wkcollis1-eng/CO2-Monitor/hardware/adafruit-scd30/adafruit_products_SCD30_sch.png

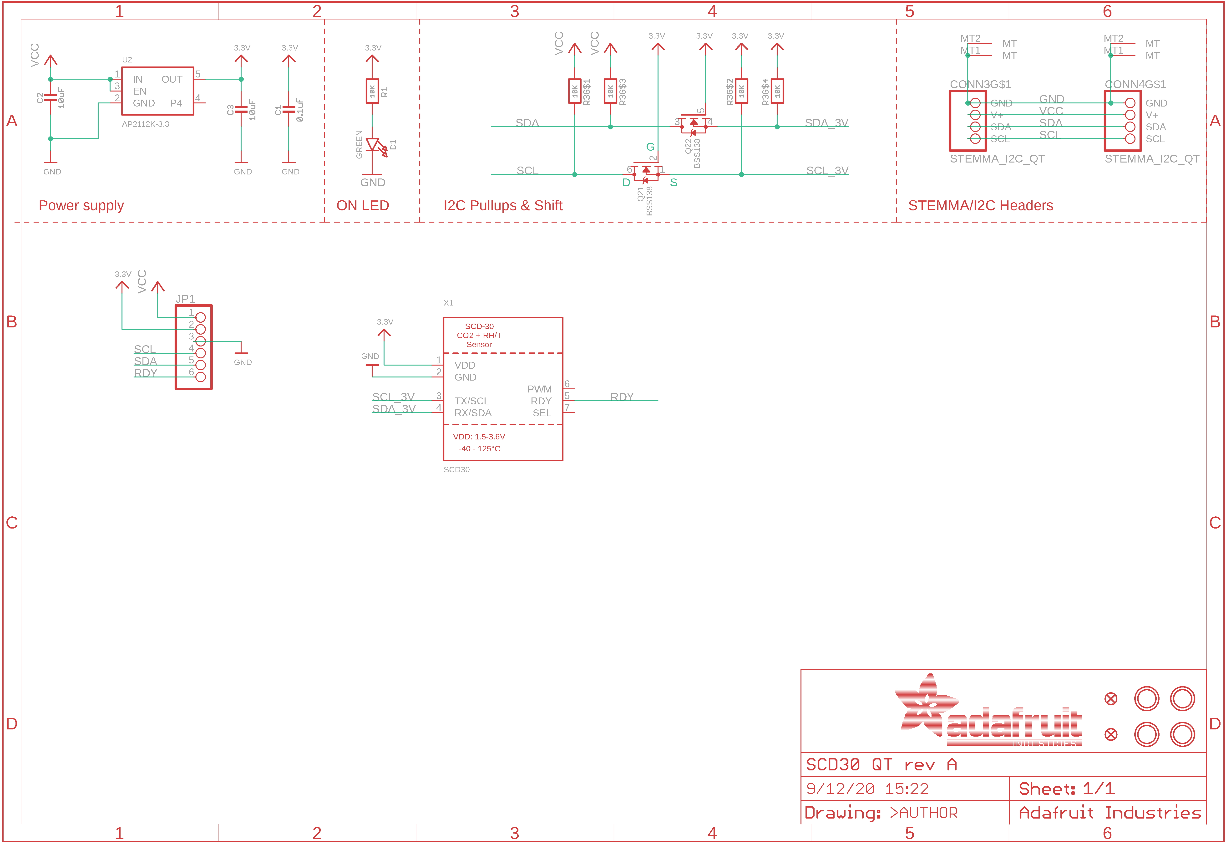
hardware/adafruit-scd30/adafruit_products_SCD30_sch.png
