wkcollis1-eng/CO2-Monitor/hardware/3d/usb-c-type-c-male-connector-cable-1.snapshot.1/USB C Male connector cable.STEP

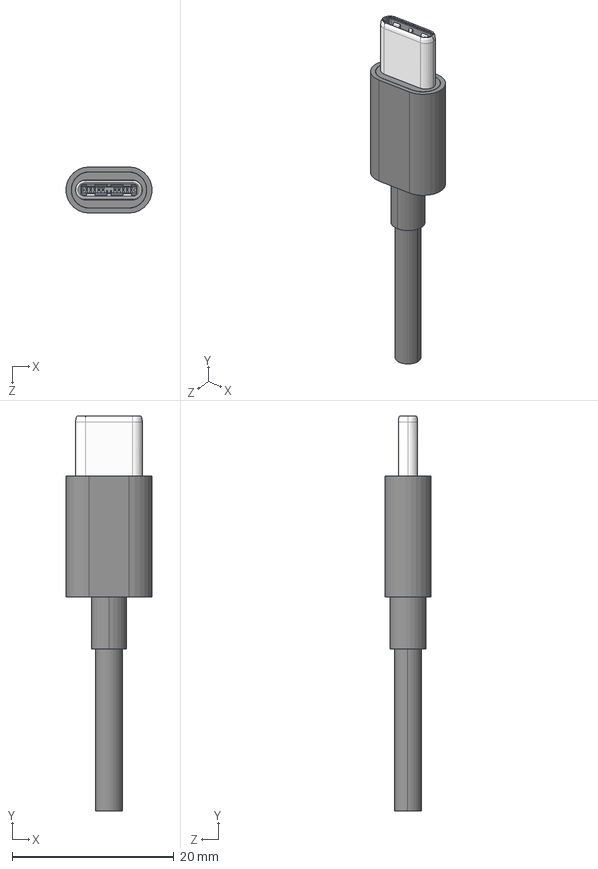
[picture p12: CAD file, 2026-10-18]
hardware/3d/usb-c-type-c-male-connector-cable-1.snapshot.1/USB C Male connector cable.STEP
10.6 x 48.8 x 5.70 mm
USB C Male Cover
USB C Male Connector Board
USB C Male Wire Tube
USB C Male Top Cover
USB C Cable
