wkcollis1-eng/CO2-Monitor/hardware/3d/4867 Adafruit SCD30.step

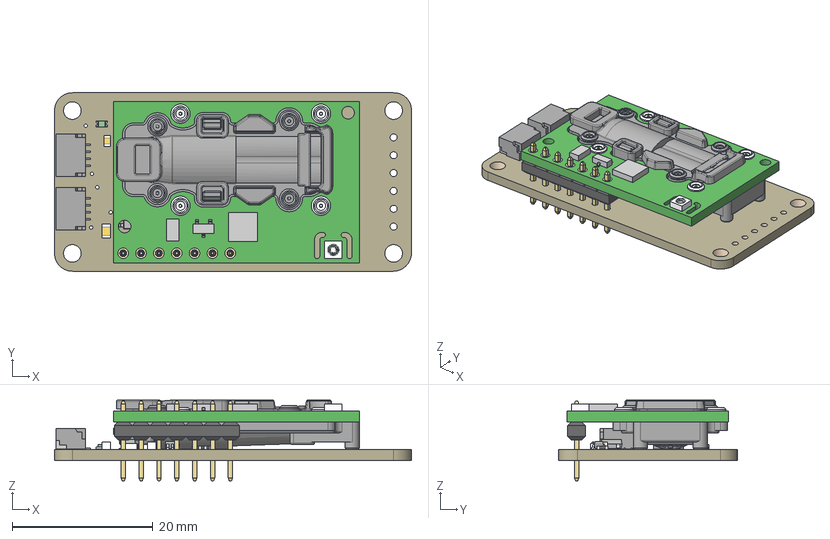
[picture p13: CAD file, 2026-10-18]
hardware/3d/4867 Adafruit SCD30.step
50.8 x 25.4 x 11.5 mm
Board
10uF x 2
AP2112K-3.3
10K x 2
10K_1
BSS138
STEMMA_I2C_QT x 2
GREEN
SCD30
1x7-male-header v1
