wkcollis1-eng/CO2-Monitor/hardware/CO2 Monitor.kicad_pcb

## KiCad design hardware/CO2 Monitor.kicad_pcb (2026-10-18)

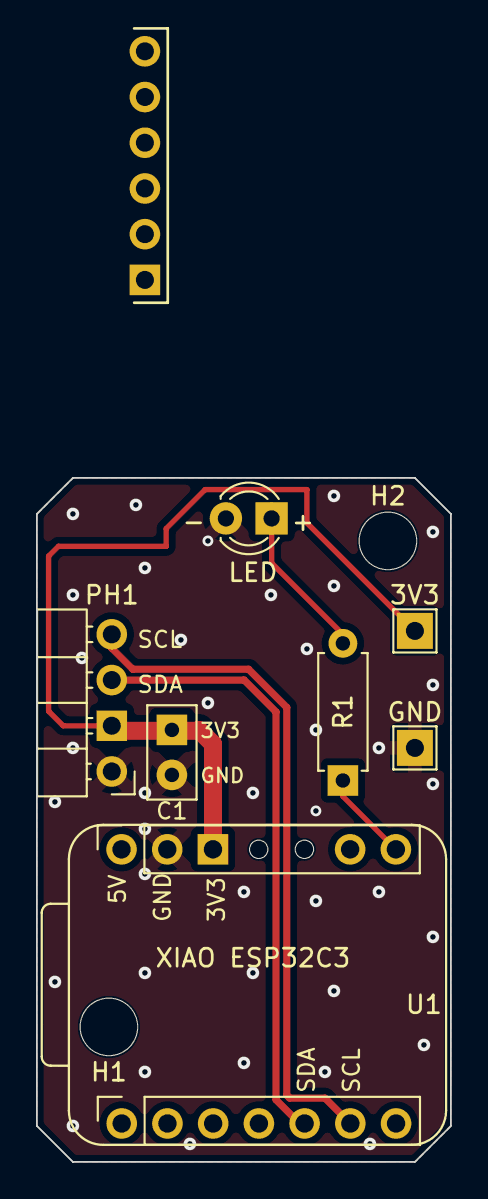
[picture p14: board CO2 Monitor.kicad_pcb from above]

Board: 2 copper layers, 23.0 x 38.0 mm, 9 parts (0 on the bottom side), 6 nets.

Parts:
3V3: TestPoint_THTPad_2.0x2.0mm_Drill1.0mm
C1: .1uF 50V; C_Disc_D5.0mm_W2.5mm_P2.50mm
GND: TestPoint_THTPad_2.0x2.0mm_Drill1.0mm
H1, H2: M3; MountingHole_3.2mm_M3
LED: Green; LED_D3.0mm
PH1: PinHeader_1x04_P2.54mm_Horizontal
R1: 1K Ohm; R_Axial_DIN0207_L6.3mm_D2.5mm_P7.62mm_Horizontal
U1: Xiao ESP32C3; XIAO ESP32C3

Connections:
+3V3: 3V3.1, C1.2, PH1.2, U1.3V3
GND: C1.1, GND.1, LED.1, PH1.1, U1.GND
GPIO20LED: R1.1, U1.GPIO20
LED: LED.2, R1.2
SCL: PH1.4, U1.SCL
SDA: PH1.3, U1.SDA
