wkcollis1-eng/CO2-Monitor/hardware/adafruit-scd30/Adafruit SCD30.brd

## EAGLE design hardware/adafruit-scd30/Adafruit SCD30.brd (2026-10-18)

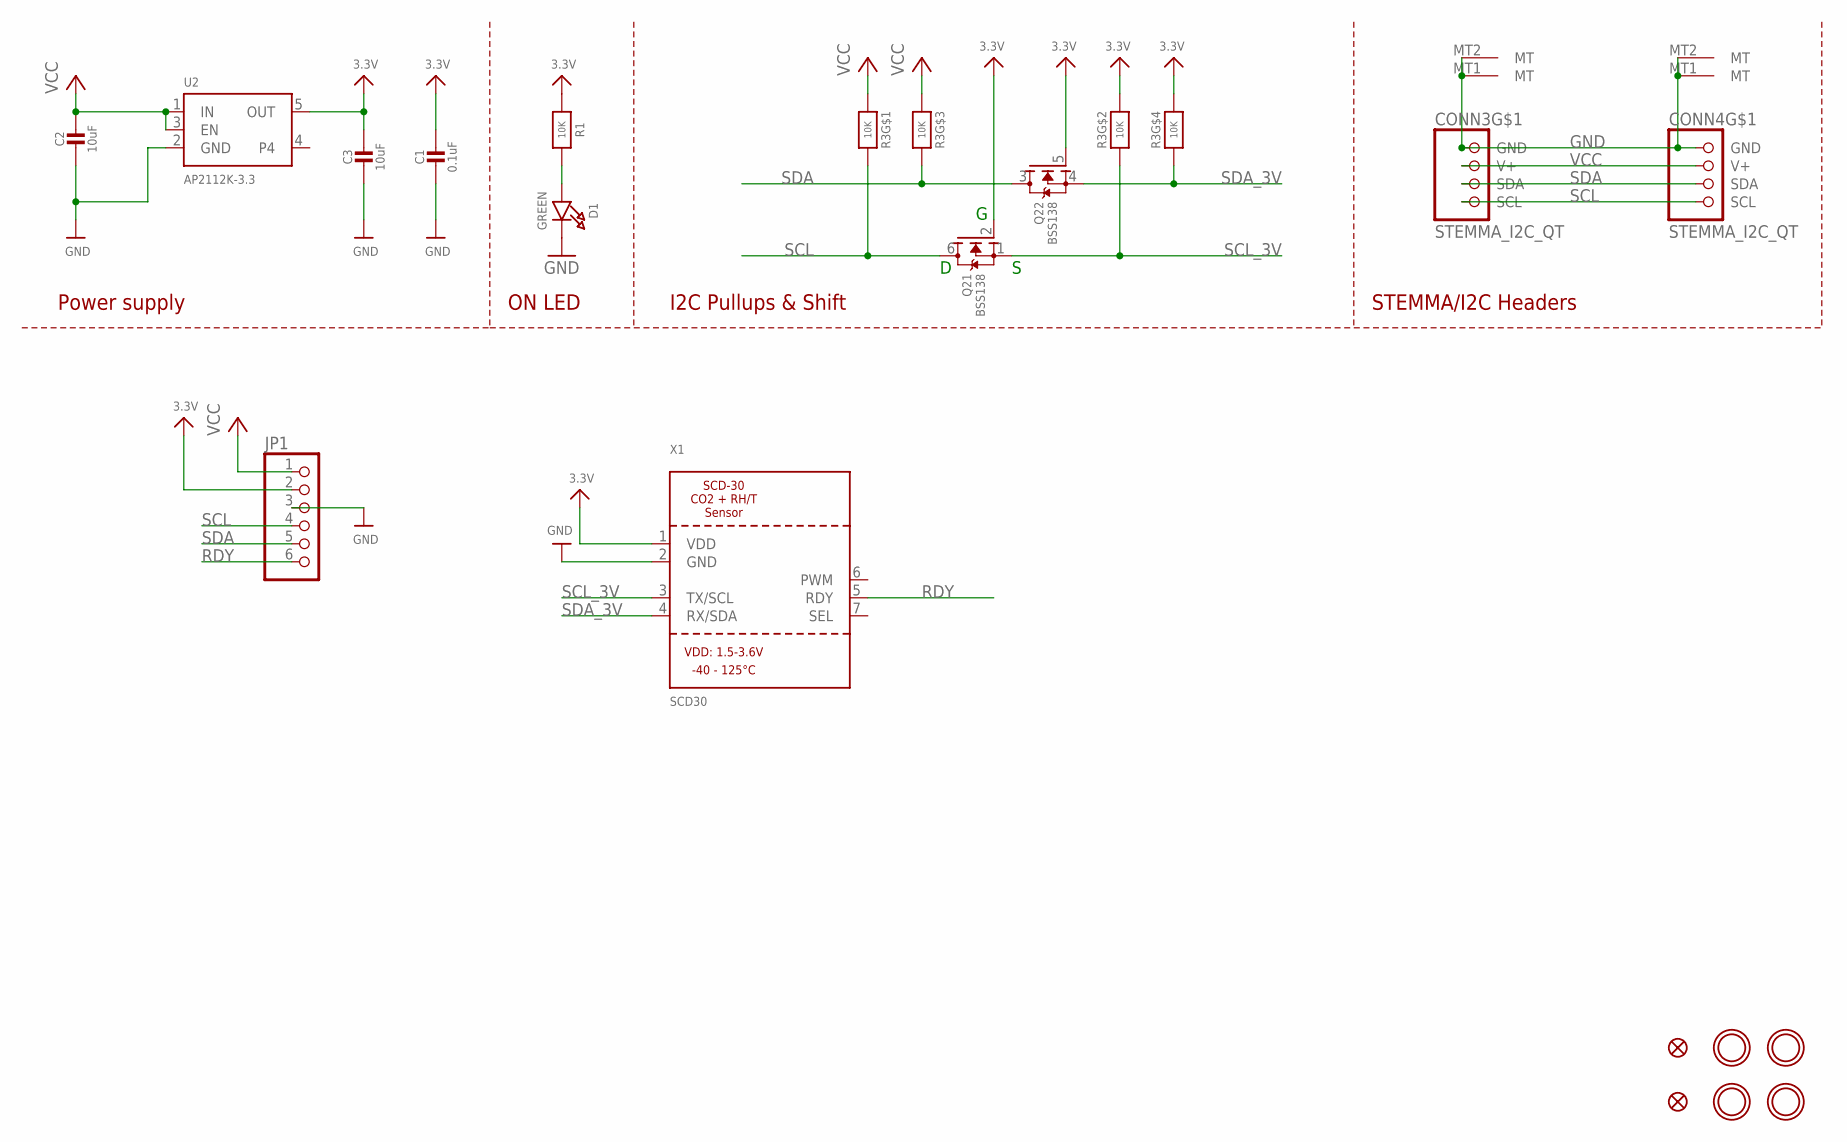
[picture p15: schematic Adafruit SCD30.sch]

Parts:
C1: 0.1uF; 0603-NO
C2, C3: 10uF; 0805-NO
CONN3, CONN4: STEMMA_I2C_QT; JST_SH4
D1: GREEN; CHIPLED_0603_NOOUTLINE
FID3, FID4: FIDUCIAL_1MM
JP1: HEADER-1X670MIL; 1X06_ROUND_70
Q2: BSS138; SOT363
R1: 10K; 0603-NO
R3: 10K; RESPACK_4X0603
U2: AP2112K-3.3; SOT23-5
U$1, U$17, U$19, U$21: MOUNTINGHOLE2.5; MOUNTINGHOLE_2.5_PLATED
X1: SCD30

Connections:
3.3V: C1.1, C3.1, JP1.2, Q2.2 (G), Q2.5 (G), R1.1, R3.2 (1), R3.4 (1), U2.5 (OUT), X1.1 (VDD)
GND: C1.2, C2.2, C3.2, CONN3.1 (GND), CONN3.MT1 (MT), CONN3.MT2 (MT), CONN4.1 (GND), CONN4.MT1 (MT), CONN4.MT2 (MT), D1.C, JP1.3, U2.2 (GND), X1.2 (GND)
unnamed: D1.A, R1.2
RDY: JP1.6, X1.5 (RDY)
SCL: CONN3.4 (SCL), CONN4.4 (SCL), JP1.4, Q2.6 (D), R3.8 (2)
SCL_3V: Q2.1 (S), R3.7 (2), X1.3 (TX/SCL)
SDA: CONN3.3 (SDA), CONN4.3 (SDA), JP1.5, Q2.3 (D), R3.6 (2)
SDA_3V: Q2.4 (S), R3.5 (2), X1.4 (RX/SDA)
VCC: C2.1, CONN3.2 (V+), CONN4.2 (V+), JP1.1, R3.1, R3.3 (1), U2.1 (IN), U2.3 (EN)

Notes on the sheet:
I2C Pullups & Shift
STEMMA/I2C Headers
ON LED
Power supply

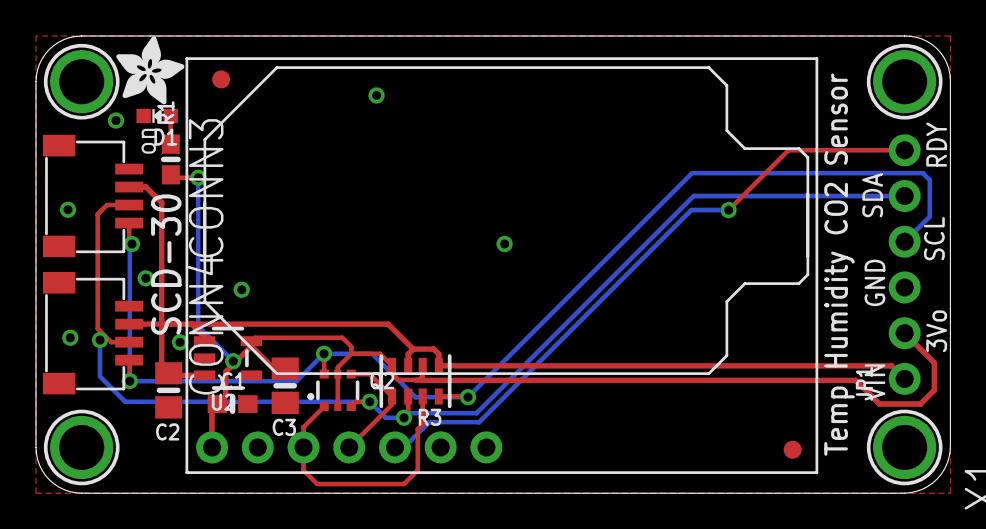
[picture p16: board Adafruit SCD30.brd from above]

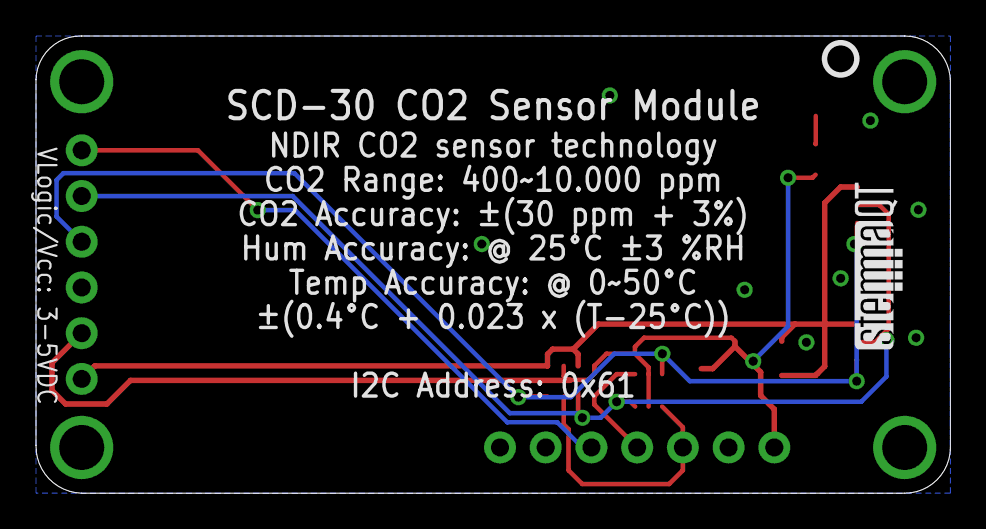
[picture p17: board Adafruit SCD30.brd from below]

Board: 2 copper layers, 50.8 x 25.4 mm, 21 parts (2 on the bottom side), 9 nets.

Other parts of the board:
U$22: ADAFRUIT_3.5MM
U$25: PCBFEAT-REV-040
U$30: STEMMAQT
