wkcollis1-eng/CO2-Monitor/(commit log)

2026-10-18 Repository scaffolding: .gitignore, gitleaks rules, pre-commit config
    .gitleaks.toml and .pre-commit-config.yaml come from the Tools repo. Two
    repo-local changes to the latter, both explained in the file:
    check-added-large-files raised to 5 MB for the vendor STEP models and
    datasheets, and hardware/ + docs/ excluded from the two whitespace fixers
    so KiCad and vendor files stay as their tools and publishers wrote them.
    .gitignore keeps secrets.yaml out first of all, then the ESPHome and
    watchdog-harness build output and KiCad's per-user state.
2026-10-18 Import the CO2 node firmware, harness, KiCad board and vendor sources
    Moved from C:\sandbox\co2_nodes (the ESPHome draft and its watchdog sim)
    and OneDrive\Desktop\CO2 Monitor (the KiCad enclosure fit-check board, the
    SCD30 and Hammond 1551V4 sources). Every file is byte-identical to its
    source (cmp, 2026-10-18); only the location changed:
    co2_nodes/*.yaml -> esphome/
    co2_nodes/harness/ -> harness/ (gen.py, faults.py follow, ruff)
    CO2 Monitor/KiCad/ -> hardware/ (relative layout inside unchanged)
    vendor STEP models -> hardware/3d/
    Adafruit SCD30 EAGLE -> hardware/adafruit-scd30/
    datasheets, drawings -> docs/
    hardware/3d/seeed-studio-xiao-esp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
    [4867 Adafruit SCD30.step, Adafruit SCD30.brd, Adafruit SCD30.sch, CO2 Monitor.kicad_pcb, Seeed_XIAO_ESP32C3.kicad_sch, USB C Male connector cable.STEP, seeed-studio-xiao-esp32-c3.step]
2026-10-18 harness: import gen.py and faults.py, ruff-formatted, E741 fixed
    The watchdog sim's two scripts, from C:\sandbox\co2_nodes\harness. They
    are the only files of the import that are not byte-identical to their
    source, and are committed apart from it for that reason:
    - ruff (pinned v0.15.9) blocked on E741, `l` as a loop variable, three
    times in faults.py: renamed to `line`.
    - ruff-format reflowed both files (double quotes, wrapped calls).
    - gen.py's trailing "# the stub below models exactly this filter" moved
    onto its own line above its assert, so the formatter does not wrap
    the assert around it. Comment kept, word for word.
    Behaviour-identical, shown two ways on 2026-10-18: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
2026-10-18 hardware: 3D model paths relative to ${KIPRJMOD}, so a clone resolves them
    Five (model "...") paths in CO2 Monitor.kicad_pcb were absolute paths into
    C:/Users/wkcol/OneDrive/Desktop/, so they resolved on one machine only, and
    only until those folders moved. Each is rewritten as a single span, matched
    exactly once:
    SCD30 STEP -> ${KIPRJMOD}/3d/4867 Adafruit SCD30.step
    Hammond 1551V4 base -> ${KIPRJMOD}/CO2_Monitor/CO2_Monitor.3dshapes/Hammond_1551V4_Base.step
    Hammond 1551V4 cover -> ${KIPRJMOD}/CO2_Monitor/CO2_Monitor.3dshapes/Hammond_1551V4_Cover.step
    USB-C cable STEP -> ${KIPRJMOD}/3d/usb-c-type-c-male-connector-cable-1.snapshot.1/USB C Male connector cable.STEP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
    [CO2 Monitor.kicad_pcb]
2026-10-18 pre-commit: correct the largest-file figure in the --maxkb comment
    The comment gave 4,254,159 bytes for the USB-C cable STEP. That is the
    size of the GrabCAD snapshot .zip the STEP arrived in, which is not in
    this repo. The STEP itself is 4,253,334 bytes, still the largest tracked
    file. The error is recorded beside the corrected figure. The 5120 KB limit
    does not change.
2026-10-18 Licences and third-party notices
    Three-way model, as mmwave-presence-node: CERN-OHL-S v2 for hardware/,
    MIT for esphome/ and harness/, CC BY 4.0 for the README. LICENSE-CODE and
    LICENSE-HARDWARE are mmwave's files unchanged (same blobs).
    THIRD_PARTY_NOTICES.md records, for each vendor file, its source and the
    terms that apply, and says where that could not be verified:
    - the SCD30 STEP (Adafruit_CAD_Parts, MIT): the notice is reproduced
    - the SCD30 EAGLE board/schematic (Adafruit-SCD-30-PCB, CC BY-SA 3.0)
    - the Hammond 1551V4 meshes, split into base and cover (a modification)
    - the USB-C cable mesh: author and licence NOT recovered (GrabCAD 403)
    - the footprints and schematic redraw derived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
2026-10-18 README: what the node is for, status, hardware, firmware, harness, board caveats
    Written for readers who may build the node. It covers the three unattended
    moments the firmware is built around, a status table that claims no more
    than is on record (draft firmware, compiled on ESPHome 2026.9.1, watchdog
    host-simulated, not deployed, no new PCB), the PH1 pinout and the 3V3-only
    rule, the enclosure fit figures with their provenance tags, the entities,
    the outdoor-FRC procedure, how to run the harness and what it does not
    prove, and the known board caveats:
    - design rules inherited from another board
    - a DRC count that varies run to run on an unchanged file
    - 7 unresolved model refs
    - broken libr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
2026-10-18 README: two 3D renders of the fit-check model
    Bill's KiCad 3D-viewer renders (cover off; cover lifted), placed in
    hardware/ and embedded after the intro, as in mmwave-presence-node.
    The caption says they are renders, not photographs, that the standoff
    height is not final, and that the model does not show the USB cable's
    exit from the enclosure.
    Both renders show the USB-C plug mesh whose provenance was not
    recovered, so THIRD_PARTY_NOTICES.md no longer says "nothing else uses
    it", and the README's third-party row says so too.
    Checked: git diff -U0 shows 3 README hunks + 1 notices hunk only;
    local links/anchors bad: 0 (injected bad anchor + bad image path -> 2);
    check_provenance --all: 0 WA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
2026-10-27 firmware 1.1: fault-only LED and an LED Test button
    The LED strobes at 5 Hz while CO2 Sensor Fault is on, including after a
    recovery reboot, and is dark the rest of the time. LED Test strobes it for
    15 s, to prove the LED and that it can be seen.
    harness/led.py tests the LED lambda both ways, the way faults.py tests the
    watchdog. The ruff-format hook reformatted it on the way in; the AST is
    identical to the file that was run.
    Gate at this commit: "FAULTS: PASS (0 of 6 directions wrong)",
    "LED: PASS (0 of 5 directions wrong)". Flashed to the bedroom node
    2026-10-27.
2026-10-27 firmware 1.2: a 2 s measurement window before forced recalibration
    Sensirion requires a 2 s measurement rate for at least two minutes before
    FRC [S: SCD30 Interface Description v1.0-D1, p14]; the node normally
    measures every 60 s. frc_prepare opens the window, and the Calibration
    entity reads "2 s window: wait", then "ready", then "applied N ppm" or the
    reason it was refused. forced_recalibration is refused before ready, or
    outside 400 to 2000 ppm.
    The window ends with a reboot 20 min after frc_prepare. Setup writes the
    60 s rate back, because the SCD30 keeps its interval in non-volatile memory
    (p9), so a forgotten window cannot leave it at 2 s.
    Gate at this commit: "FAULTS: PASS (0 of 6 d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
2026-10-27 firmware 1.3: SCD30 temperature and humidity as diagnostics
    Bill: "can we see the units temp/humidity its recording?" Two diagnostic
    sub-sensors, named "(self-heated)": the SCD30 heats itself [S: SCD30
    Interface Description v1.0-D1, p15], so they are not room readings. They
    are the only view of the thermal equilibrium that calibration assumes
    [S: SCD30 Design-In Guidelines D1, p2]. No temperature_offset.
    The stale watchdog blanks both with CO2: one read carries all three, and a
    failed read publishes none (scd30.cpp:186-192).
    Harness: a timed check that both go unknown with CO2, a check that a
    healthy sensor never blanks them, and faults F6-F8. The first draft checked
    the end state and coul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
2026-10-27 README: the FRC acceptance rule, and the 2026-10-27 porch calibration
    The rule used: each minute's sd <= 5 ppm, the 3 minute means within 5 ppm
    of each other, and the 3-min mean no higher than 469 ppm [D: 426 + 43].
    There is no lower bound on purpose: a plume can only raise outdoor CO2.
    The first rule had one, and it rejected a flat window that read about
    82 ppm low (R13).
    Records the calibration: 3-min mean 340.9 ppm, then 425.7 after FRC at
    426 [M]; "PERSIST: PASS (after - before = -2.0 ppm, limit 43)" through
    the window-end reboot. Says to judge nothing from the first 5 min after
    a boot, because 2 of 3 boots that day started low and climbed.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
2026-10-27 README: R13 - the low start was the measurement rate, not the boot
    The calibration record said the first readings after 2 of 3 boots
    started low and climbed. They did not follow the boots. Each climb began
    when frc_prepare moved the SCD30 from 60 s to 2 s, and each return to
    60 s brought the reading down again: in the same porch air the 60 s
    reading sat 60 to 70 ppm below the 2 s reading [D, n = 3 transitions,
    one unit, one afternoon]. The mechanism is unknown.
    FRC is taken at 2 s, as the Interface Description asks (p14), and the
    node runs at 60 s, so its readings likely sit about 65 ppm low [I,
    falsified by the node at 60 s outdoors, settled, reading near 426]. The
    PERSIST figure compared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
2026-10-27 firmware 1.4: measure every 2 s; CO2 is the 1-minute mean, CO2 (2 s) every reading
    The SCD30 read 60-70 ppm lower at 60 s than at 2 s in the same air, and
    FRC is taken at 2 s (Interface Description p14). 1.4 runs at 2 s always.
    - scd30 update_interval 2s; its CO2 becomes co2_2s, "CO2 (2 s)".
    - "CO2" is a copy of it through throttle_average 60s, so the entity id
    and its history carry on. SCD30 temperature and humidity: 60 s means.
    - frc_prepare, frc_window and g_frc_open_ms removed. FRC is allowed from
    2 min after boot (g_frc_ready, set by on_boot).
    - Calibration: "2 s rate; FRC wait (2 min after boot)" / "2 s rate; FRC
    ready", plus the last result; published only on a change.
    - The wa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
2026-10-27 README: firmware 1.4 - always 2 s, the 1-minute mean, the OTA step
    - Status, Entities and Settings for 1.4: CO2 is the 1-minute mean, CO2
    (2 s) is new (up to 43,200 recorder states a day [D: 86,400 / 2]).
    - Calibration: frc_prepare is gone; FRC is allowed from 2 min after boot.
    - The OTA step, 60 s -> 2 s: about +86 ppm in the 2 s readings and +78
    to +85 in the settled 1-minute means, against a +60 to 70 prediction
    [M/D, one switch, one room].
    - Watchdog timings at 2 s; ESPHome 2026.10.0 minimum; harness section:
    eleven faults, "FAULTS: PASS (0 of 12 directions wrong)".
2026-11-01 README: as-built photos and the first five nights of field data
    The bedroom node is built and running, so the page now leads with
    photographs instead of renders, and the stale status lines go: the
    "draft, not deployed" badge, "no node has been built yet", and the
    Status LED row, which still said it is kept dark in an opaque box. It
    has been the fault light since 1.1, and the vented box shows it.
    New field-results section: 111.65 h on firmware 1.4, with conclusions,
    node health, the room's level night by night, the furnace association
    and what the data does not establish. Every figure carries its tag.
2026-11-01 README: as-built standoffs, occupancy and the waking hour
    The build used 3 mm standoffs, so the fit section gains calculated
    clearances at that height and the open question goes.
    Two adults sleep in the room every night and are usually awake between
    06:00 and 07:00. Three mornings were already falling before 06:00 with a
    cycle running, so getting up does not cover them, just as the furnace
    does not cover Oct 30. Conclusion 4 now says no single cause covers the
    five mornings.
2026-11-01 README: the XIAO's header and the door
    Bill, 2026-11-01. The XIAO is on a 2.5 mm pin header, and the bedroom door
    is open all the time, so neither head count nor the door explains the
    differences between nights.
    The waking-hour sentence now carries only what the analysis needs.
